jwaeles/xmas-2019/README.md

# xmas-2019
Dynamic christmas gift label that scrolls the name of the person it's for when you shake the gift
