jwaeles/xmas-2019/hardware/planb_bom_ok.xlsx

Comment | Designator | Footprint | LCSC Part #（optional）
100nF | C3,C1 | C_0603_1608Metric | C14663
ATmega328P-AU | U1 | TQFP-32_7x7mm_P0.8mm | C14877
WHITE | D1,D2,D3,D4,D5,D6,D7,D8,D9,D10,D11,D12,D13,D14,D15,D16,D17,D18,D19,D20,D21,D22,D23,D24,D25,D26,D27,D28,D29,D30,D31,D32,D33,D34,D35,D36,D37,D38,D39,D40,D41,D42,D43,D44,D45,D46,D47,D48,D49,D50,D51,D52,D53,D54,D55,D56,D57,D58,D59,D60,D61,D62,D63,D64,D65,D66,D67,D68,D69,D70,D71,D72,D73,D74,D75,D76,D77,D78,D79,D80,D81,D82,D83,D84,D85,D86,D87,D88,D89,D90,D91,D92,D93,D94,D95,D96,D97,D98,D99,D100,D101,D102,D103,D104,D105,D106,D107,D108,D109,D110,D111,D112 | LED_0603_1608Metric | C2290
S8050 | Q2 | SOT-23 | C2146
Si2301CDS | Q3,Q1,Q4,Q5 | SOT-23 | C10487
100K | R2,R4,R6 | R_0603_1608Metric | C25803
1K | R3 | R_0603_1608Metric | C21190
10K | R5,R1 | R_0603_1608Metric | C25804
TM1640 | U2 | SOIC-28W_7.5x17.9mm_P1.27mm | C41327
10uF | C2 | C_0805_2012Metric | C15850
SM4007PL | D113 | D_SOD-123F | C64898
500mA | F1 | Fuse_0805_2012Metric | C261942
