jwaeles/xmas-2019/hardware/plan_b.kicad_pcb

## KiCad design hardware/plan_b.kicad_pcb (2019-12-04)

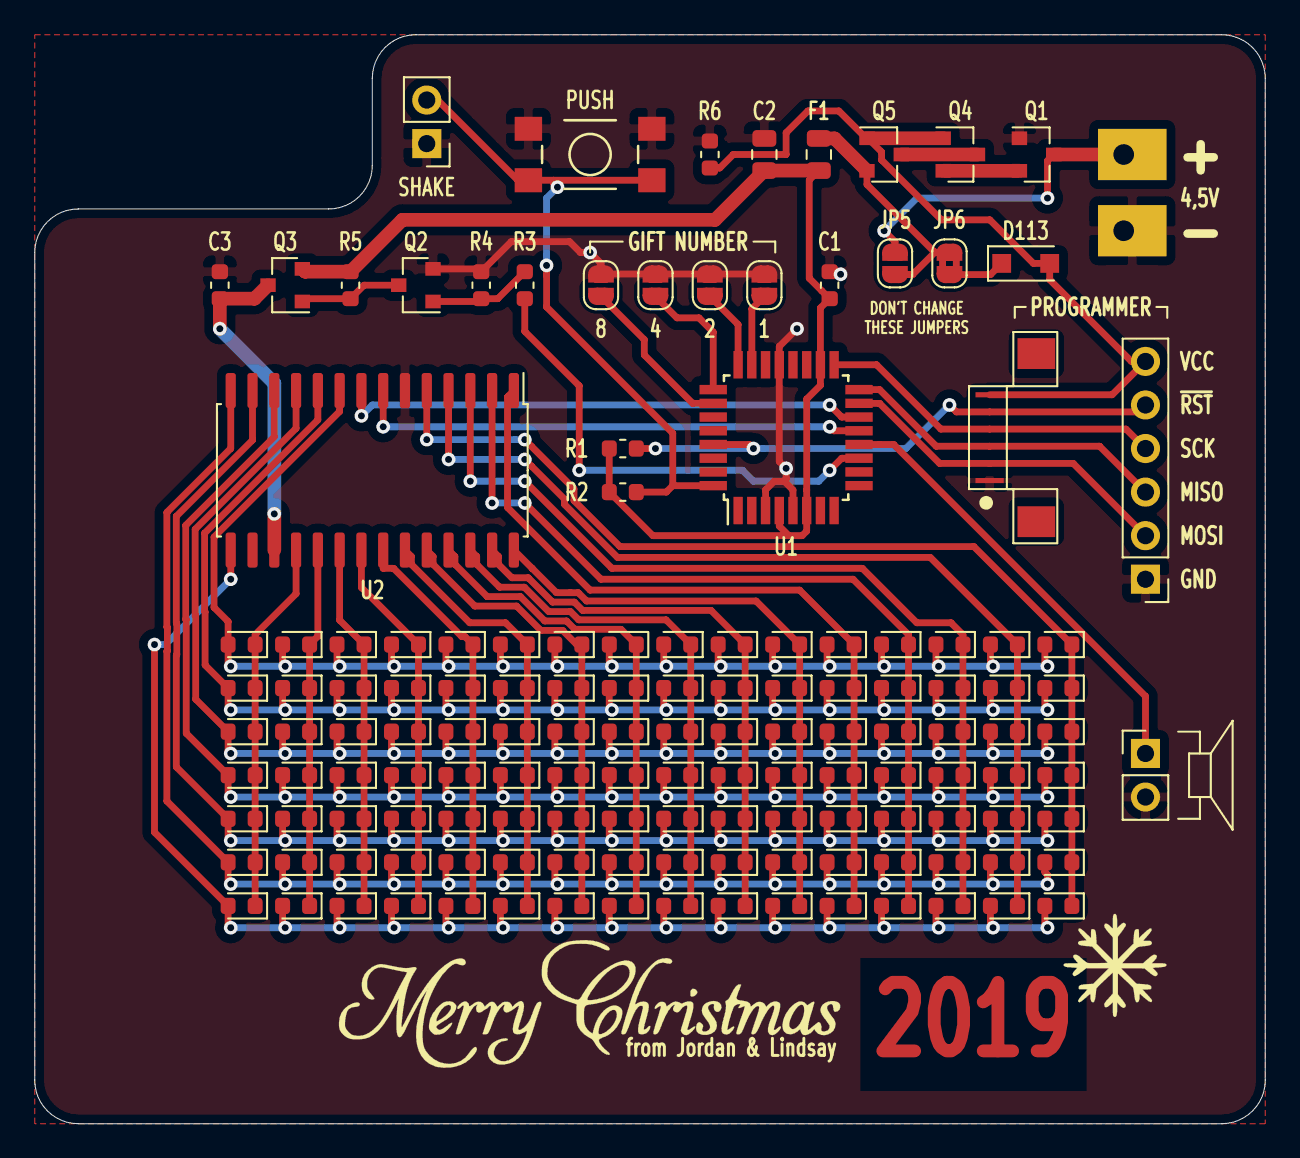
[picture p5: board plan_b.kicad_pcb from above]

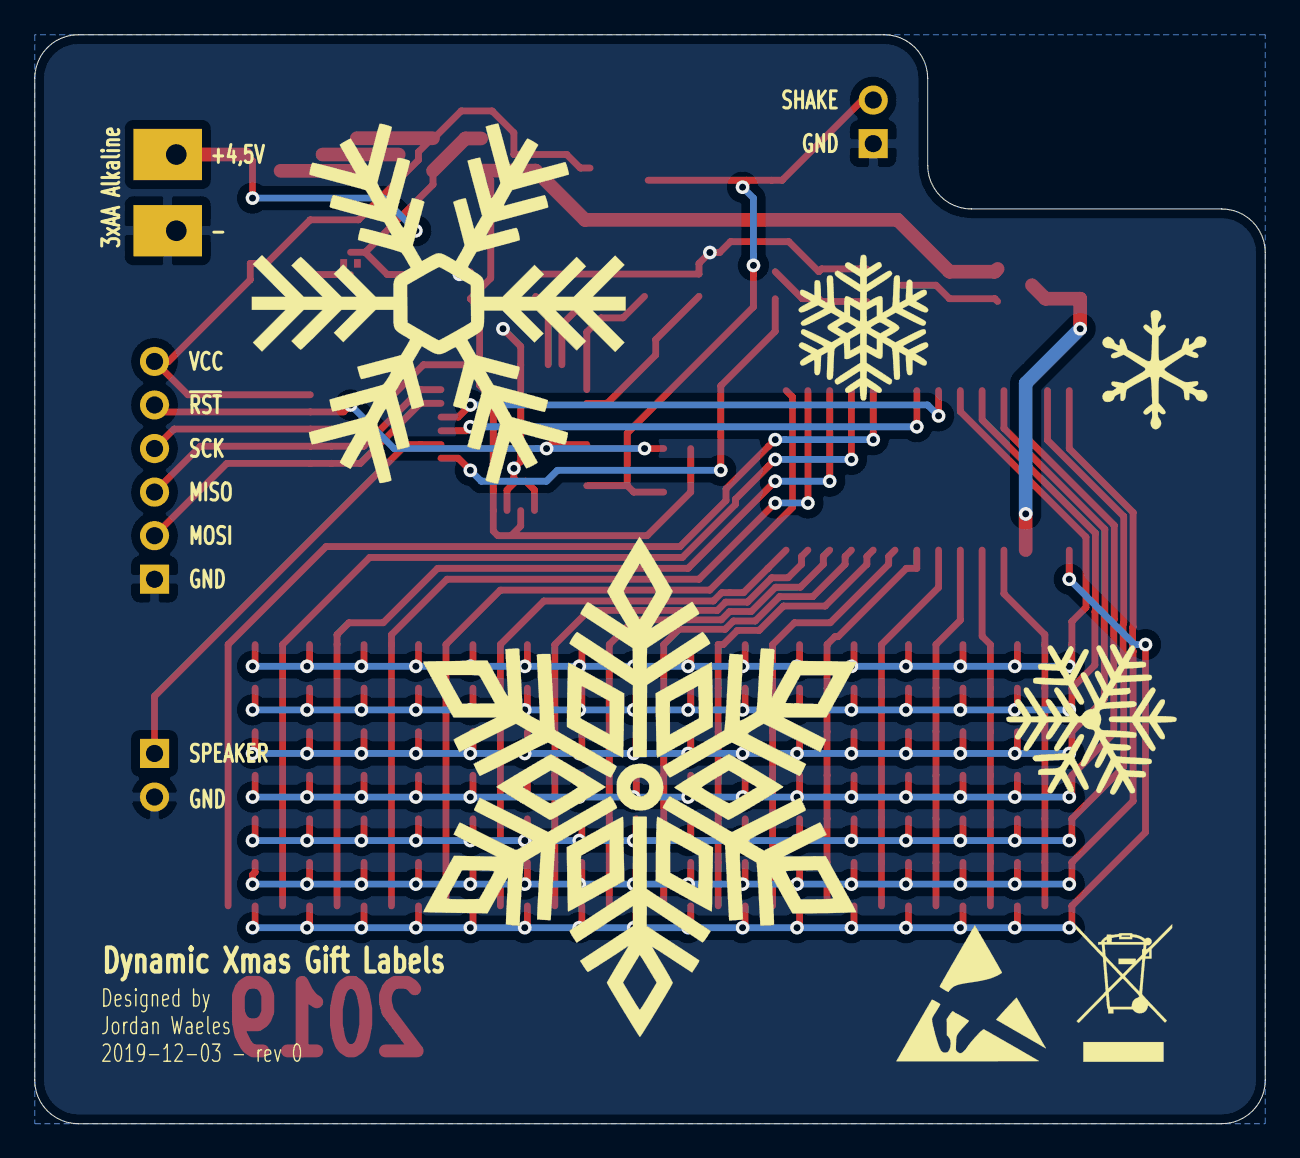
[picture p6: board plan_b.kicad_pcb from below]

Board: 2 copper layers, 71.8 x 63.5 mm, 150 parts (5 on the bottom side), 47 nets.

Parts:
C1, C3: 100nF; C_0603_1608Metric
C2: 10uF; C_0805_2012Metric
D1, D2, D3, D4, D5, D6, D7, D8, D9, D10, D11, D12, D13, D14, D15, D16, D17, D18, D19, D20, D21, D22, D23, D24, D25, D26, D27, D28, D29, D30, D31, D32, D33, D34, D35, D36, D37, D38, D39, D40, D41, D42, D43, D44, D45, D46, D47, D48, D49, D50, D51, D52, D53, D54, D55, D56, D57, D58, D59, D60, D61, D62, D63, D64, D65, D66, D67, D68, D69, D70, D71, D72, D73, D74, D75, D76, D77, D78, D79, D80, D81, D82, D83, D84, D85, D86, D87, D88, D89, D90, D91, D92, D93, D94, D95, D96, D97, D98, D99, D100, D101, D102, D103, D104, D105, D106, D107, D108, D109, D110, D111, D112: WHITE; LED_0603_1608Metric
D113: SM4007PL; D_SOD-123F
F1: 500mA; Fuse_0805_2012Metric
J1: +4,5V; LARGE_PAD
J2: -; LARGE_PAD
J3: PROG; FPC_6_1MM_C262383
J4: PROG; PinHeader_1x06_P2.54mm_Vertical
JP1: 1; SolderJumper-2_P1.3mm_Open_RoundedPad1.0x1.5mm
JP2: 2; SolderJumper-2_P1.3mm_Open_RoundedPad1.0x1.5mm
JP3: 4; SolderJumper-2_P1.3mm_Open_RoundedPad1.0x1.5mm
JP4: 8; SolderJumper-2_P1.3mm_Open_RoundedPad1.0x1.5mm
JP5: BYPASS PROTECTION; SolderJumper-2_P1.3mm_Open_RoundedPad1.0x1.5mm
JP6: PROG VCC; SolderJumper-2_P1.3mm_Bridged2Bar_RoundedPad1.0x1.5mm
LS1: 8 ohm; PinHeader_1x02_P2.54mm_Vertical
Q1, Q3, Q4, Q5: Si2301CDS; SOT-23
Q2: S8050; SOT-23
R1, R5: 10K; R_0603_1608Metric
R2, R4, R6: 100K; R_0603_1608Metric
R3: 1K; R_0603_1608Metric
Ref**: Val**; flake-9-30mm
Ref**#2: Val**; flake-2-10mm
Ref**#3: Val**; flake-40-8mm
Ref**#4: Val**; flake-3-10mm
Ref**#5: Val**; flake-11-22mm
Ref**#6: Val**; flake-48-7mm
Ref**#7: Val**; merry-xmas
SW1: SHAKE; PinHeader_1x02_P2.54mm_Vertical
SW2: PUSH; TL3305_TACT_SWITCH_OK
U1: ATmega328P-AU; TQFP-32_7x7mm_P0.8mm
U2: TM1640; SOIC-28W_7.5x17.9mm_P1.27mm

Connections:
/GIFTNR_1: JP1.1, U1.23
/GIFTNR_2: JP2.1, U1.24
/GIFTNR_4: JP3.1, U1.25
/GIFTNR_8: JP4.1, U1.26
/MATRIX_CLK: U1.14, U2.8
/MATRIX_DATA: U1.13, U2.7
/MATRIX_ENABLE: R3.2, U1.11
/MISO: J3.3, J4.3, U1.16
/MOSI: J3.2, J4.2, U1.15
/PROG_VCC: D113.2, J3.6, J4.6, Q4.1, Q5.1, R6.1
/PowerInput/BATT+: J1.1, JP5.1, Q1.3
/SCK: J3.4, J4.4, U1.17
/SPEAKER: LS1.1, U1.12
/TM1640/GRID1: D1.1, D2.1, D3.1, D4.1, D5.1, D6.1, D7.1, U2.18
/TM1640/GRID2: D8.1, D9.1, D10.1, D11.1, D12.1, D13.1, D14.1, U2.19
/TM1640/GRID3: D15.1, D16.1, D17.1, D18.1, D19.1, D20.1, D21.1, U2.20
/TM1640/GRID4: D22.1, D23.1, D24.1, D25.1, D26.1, D27.1, D28.1, U2.21
/TM1640/GRID5: D29.1, D30.1, D31.1, D32.1, D33.1, D34.1, D35.1, U2.22
/TM1640/GRID6: D36.1, D37.1, D38.1, D39.1, D40.1, D41.1, D42.1, U2.23
/TM1640/GRID7: D43.1, D44.1, D45.1, D46.1, D47.1, D48.1, D49.1, U2.24
/TM1640/GRID8: D50.1, D51.1, D52.1, D53.1, D54.1, D55.1, D56.1, U2.25
/TM1640/GRID9: D57.1, D58.1, D59.1, D60.1, D61.1, D62.1, D63.1, U2.26
/TM1640/GRID10: D64.1, D65.1, D66.1, D67.1, D68.1, D69.1, D70.1, U2.27
/TM1640/GRID11: D71.1, D72.1, D73.1, D74.1, D75.1, D76.1, D77.1, U2.28
/TM1640/GRID12: D78.1, D79.1, D80.1, D81.1, D82.1, D83.1, D84.1, U2.1
/TM1640/GRID13: D85.1, D86.1, D87.1, D88.1, D89.1, D90.1, D91.1, U2.2
/TM1640/GRID14: D92.1, D93.1, D94.1, D95.1, D96.1, D97.1, D98.1, U2.3
/TM1640/GRID15: D99.1, D100.1, D101.1, D102.1, D103.1, D104.1, D105.1, U2.4
/TM1640/GRID16: D106.1, D107.1, D108.1, D109.1, D110.1, D111.1, D112.1, U2.5
/TM1640/SEG1: D1.2, D8.2, D15.2, D22.2, D29.2, D36.2, D43.2, D50.2, D57.2, D64.2, D71.2, D78.2, D85.2, D92.2, D99.2, D106.2, U2.9
/TM1640/SEG2: D2.2, D9.2, D16.2, D23.2, D30.2, D37.2, D44.2, D51.2, D58.2, D65.2, D72.2, D79.2, D86.2, D93.2, D100.2, D107.2, U2.10
/TM1640/SEG3: D3.2, D10.2, D17.2, D24.2, D31.2, D38.2, D45.2, D52.2, D59.2, D66.2, D73.2, D80.2, D87.2, D94.2, D101.2, D108.2, U2.11
/TM1640/SEG4: D4.2, D11.2, D18.2, D25.2, D32.2, D39.2, D46.2, D53.2, D60.2, D67.2, D74.2, D81.2, D88.2, D95.2, D102.2, D109.2, U2.12
/TM1640/SEG5: D5.2, D12.2, D19.2, D26.2, D33.2, D40.2, D47.2, D54.2, D61.2, D68.2, D75.2, D82.2, D89.2, D96.2, D103.2, D110.2, U2.13
/TM1640/SEG6: D6.2, D13.2, D20.2, D27.2, D34.2, D41.2, D48.2, D55.2, D62.2, D69.2, D76.2, D83.2, D90.2, D97.2, D104.2, D111.2, U2.14
/TM1640/SEG7: D7.2, D14.2, D21.2, D28.2, D35.2, D42.2, D49.2, D56.2, D63.2, D70.2, D77.2, D84.2, D91.2, D98.2, D105.2, D112.2, U2.15
/~RST: J3.5, J4.5, R1.2, U1.29
/~SHAKE_INT: R2.2, SW1.2, SW2.1, U1.32
GND: C1.2, C2.2, C3.2, J2.1, J3.1, J4.1, JP1.2, JP2.2, JP3.2, JP4.2, LS1.2, Q1.1, Q2.2, R4.2, R6.2, SW1.1, SW2.2, U1.3, U1.5, U1.21, U2.6
unnamed: C3.1, Q3.3, U2.17
unnamed: D113.1, JP6.2
unnamed: F1.2, JP5.2, JP6.1, Q5.2
unnamed: Q1.2, Q4.2
unnamed: Q2.1, R3.1, R4.1
unnamed: Q2.3, Q3.1, R5.2
unnamed: Q4.3, Q5.3
VCC: C1.1, C2.1, F1.1, Q3.2, R1.1, R2.1, R5.1, U1.4, U1.6, U1.18
