jwaeles/xmas-2019/(commit log)

2019-12-04 Adding PDF of schematic
2019-12-23 Added comments on the schematic, updated PDF
    [PowerInput.sch, TM1640.sch, plan_b.sch]
